MajenkoBoards/ds-mini/Hardware/Blender/DSMini.png

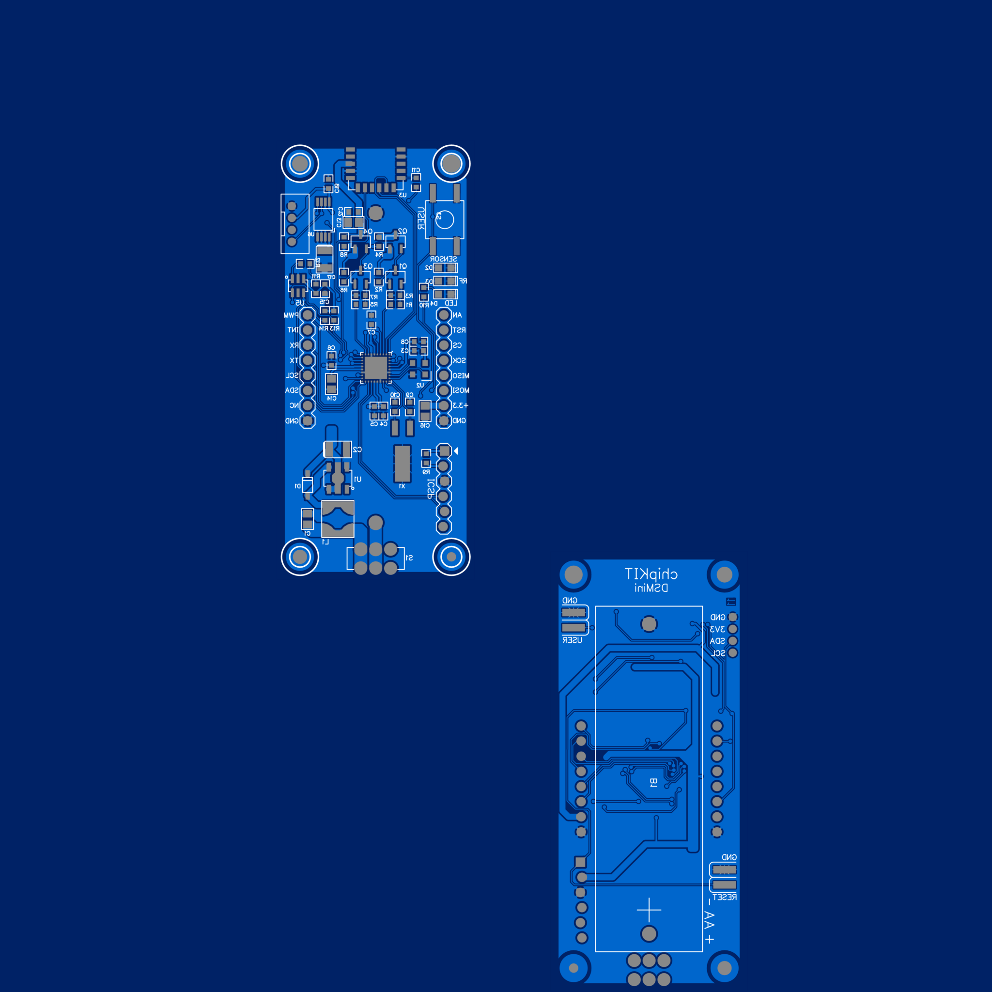
Hardware/Blender/DSMini.png
