MajenkoBoards/ds-mini/(list of files, cad)

Other CAD files:
Hardware/Blender/DSMini.blend
