MajenkoBoards/ds-mini/Hardware/gEDA/DSMini.pdf

# C1747uF SENSPWR:1

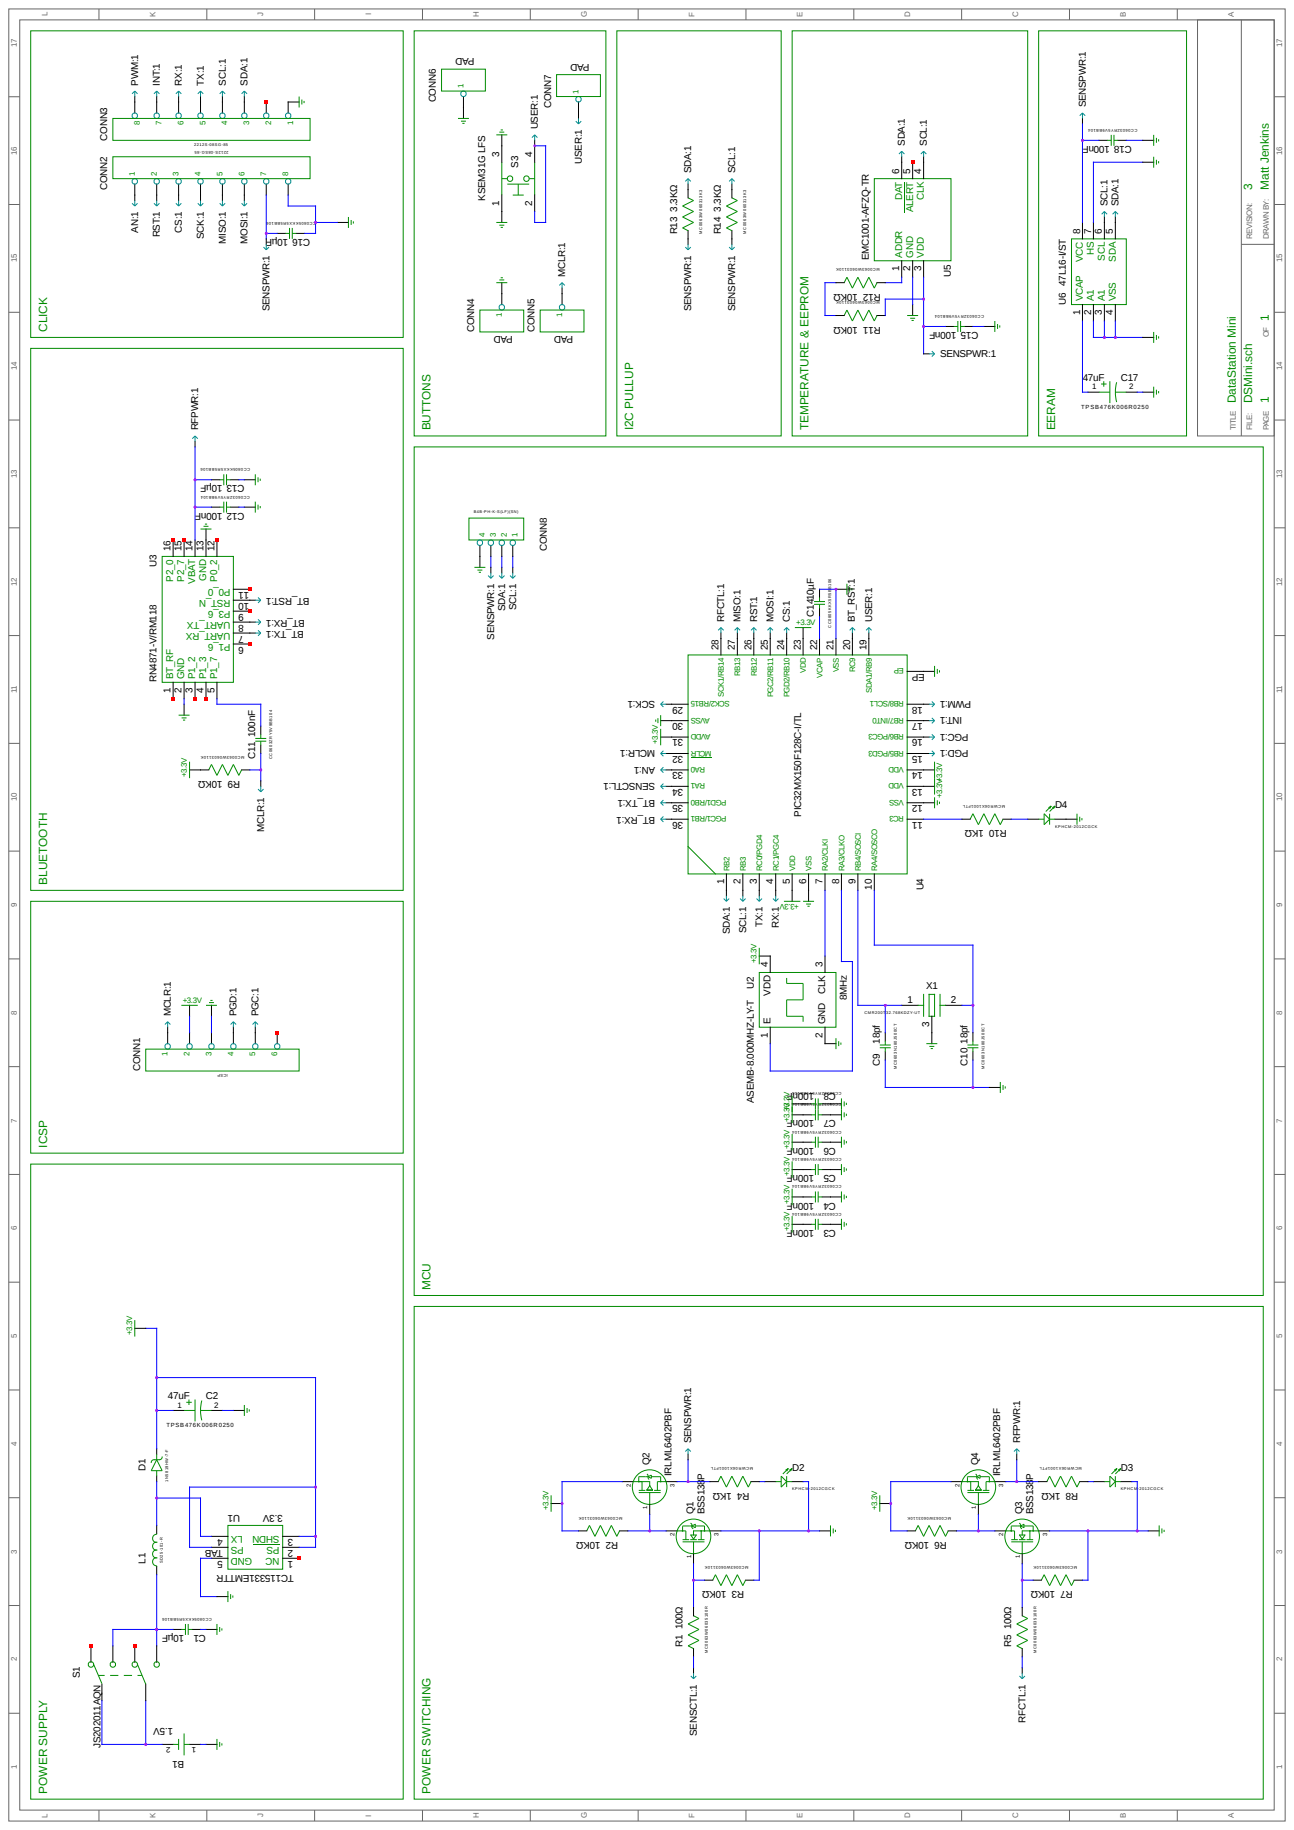
[picture p2: page 1]

POWER SUPPLY ICSP BLUETOOTH CLICK
