MajenkoBoards/ds-mini/(list of files, drawings)

Other design files:
Hardware/gEDA/DSMini.pcb
