MajenkoBoards/ds-mini/(commit log)

2017-11-29 Initial Import
    [DSMini.pcb, DSMini.sch]
2017-11-29 Added gerber and BOM files
    [DSMini.bottom.gbr, DSMini.bottommask.gbr, DSMini.bottomsilk.gbr, DSMini.fab.gbr, DSMini.outline.gbr, DSMini.top.gbr, DSMini.topmask.gbr, DSMini.toppaste.gbr]
2017-11-29 Updated BOM with missing detail
    [DSMini.pcb]
2017-11-29 Added board definitions
2017-11-29 Embedded component symbols
    [DSMini.sch]
2017-11-29 Improved bom detail
    [DSMini.csv, DSMini.pcb]
2017-11-29 Added schematic PDF
2017-12-05 Added sample sketches
2018-01-09 Added grove-like connector and changed buttons
    [DSMini.blend, DSMini.csv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]
2018-01-28 Added end functions to I2C libraries
